awklau/SimpleClock/hardware/production/bom.csv

Name | Description | Designator | Footprint | LibRef | Quantity | Manufacturer | Manufacturer_Part_Number | Manufacturer_Name | Manufacturer Part Number
10uF | Chip Multilayer Ceramic Capacitors for General Purpose, 0805, 10uF, X5R, 15%, 10%, 50V | C1, C2, C3, C4, C7, C11, C13, C14, C15, C17, C19, C21, C23, C31 | FP-GRM21B-0_2-e0_2_0_7-IPC_A | CMP-06035-004402-1 | 14
1uF | CL21 Series 0805 1uF 50V ±10% Tolerance X7R Multilayer Ceramic Chip Capacitor | C5, C6, C8, C9, C10 | FP-CL21-IPC_C | CMP-13271-004196-1 | 5
100nF | Chip Capacitor,?100 nF, +/- 10%,?16 V, -55 to 125 degC, 0402 (1005 Metric), RoHS, Tape and Reel | C12, C16, C18, C20, C22, C24, C26, C27, C28, C29, C30, C32, C33, C34 | CAPC1050X55X23ML05T13 | CMP-2000-05439-1 | 14 | Samsung Electro-Mechanics
Capacitor 0.5 pF +/- 0.1pF 25 V 0402 |  | C25 | CAPC1005X56X25ML10T15 | CMP-001-00002-6 | 1
USBLC6-2P6 | TVS DIODE 5.25V 17V SOT666 | D1 | FP-SOT-666-MFG | CMP-12225-000058-1 | 1
LED_W | Chip LED, white | DS1, DS2, DS3 | EVRL-0603-2_V | CMP-007-00002-2 | 3 | Everlight Electronics
BLM18SP601SN1D | BLM18SP601SN1D Ferrite Bead, 600 Ohm, 1.5A, 0603 Rohs Compliant: Yes | FB1, FB2, FB3, FB4, FB5, FB6, FB7, FB8 | FP-BLM18-0_15-t0_8-MFG | CMP-00260-111572297-1 | 8
217179-0001 | CONN RCP USB2.0 TYP C 16P SMD RA | J1 | FP-2171790001-MFG | CMP-04767-000028-2 | 1
SMA-J-P-H-ST-MT1 | RF Connectors / Coaxial Connectors 6 GHz, 50 Ohm SMA Jack or Plug, Cable Connector | J2, J3, J4, J5, J6, J7, J8, J9, J10, J11, J12, J13, J14, J15, J16 | FP-SMA-J-P-H-ST-MT1-MFG | CMP-002-00073-1 | 15
2p header | simple 2p header | J17, J18 | New footprint 1 | CMP-002-00072-1 | 2
DLW21HN900SQ2L | CMC 330MA 2LN 90 OHM SMD | L1 | FP-DLW21HN-MFG | CMP-06045-000050-1 | 1
AO3400A | MOSFET N-CH 30V 5.7A SOT23 | Q1 | FP-SOT23-MFG | CMP-83955-000006-1 | 1
5.1k |  | R1, R2, R7, R8, R9, R13 | RESC1005X40X25LL10T10 | CMP-2002-05746-1 | 6 | TE Connectivity / AMP
22R2J | 22R 0.063W 5% 0402 (1005 Metric) SMD | R3, R6 | RESC0402(1005)_L | CMP-009-00082-2 | 2
Resistor 1k +/-1% 0402 100 mW | Chip Resistor, 1 KOhm, +/- 1%, 0.1 W, -55 to 155 degC, 0402 (1005 Metric) | R4, R5, R10, R11, R12 | RESC1005X40X25ML05T05 | CMP-009-00009-5 | 5
100k |  | R14 | RESC1005X40X25LL10T10 | CMP-2002-05746-1 | 1 | TE Connectivity / AMP
TLV76133KVU | 18 V, 1 A fixed 3.3 V LDO regulator; TI KVU (TO-252) | U1, U2 | TO-252-3_KVU_TI_TabPin2 | TLV76133KVU | 2 | Texas Instruments |  |  | TLV76133KVUR
STM32C071FBP6 | Mainstream Arm Cortex-M0+ MCU with 128 Kbytes of Flash memory, 24 Kbytes RAM, 48 MHz CPU, 2x USART, timers, ADC, comm. I/F, USB FS, 2-3.6V | U3 | TSSOP20_STM | STM32C071FBP6 | 1 |  | STM32C071FBP6 | STMicroelectronics
mosaic-G5-T | Septentrio mosaic-G5 T multi-frequency GNSS timing receiver module, manufacturer part 410504. The 40 internal ground lands are represented by logical pin G and must be tied to ground. Pin 5 (ANT_2) is unsupported on the single-antenna T model and must be left unconnected. | U4 | MOSAIC-G5_LGA54_22P8X16P4 | mosaic-G5-T | 1
LMK1C1108APWR | 1.8V,2.5V or 3.3V asynchronous 8 channel output LVCMOS buffer 16-TSSOP -40 to 125 | U5, U6 | TSSOP16_4P5X5P1_TEX | LMK1C1108APWR | 2 |  | LMK1C1108APWR | Texas Instruments
TMP117AIDRVR | TEMPERATURE SENSOR | U7 | FP-DRV0006B-IPC_C | CMP-04948-000036-1 | 1
SIT5801AB-KV033JV-10 | SiTime SiT5801 10 MHz digitally controlled precision OCXO, exact AB-KV033JV-10 ordering variant | Y1 | SiT5801_K_9x7_LGA11 | SIT5801AB-KV033JV-10 | 1 | SiTime |  |  | SIT5801AB-KV033JV-10
