awklau/SimpleClock/hardware/simple_clock.pdf

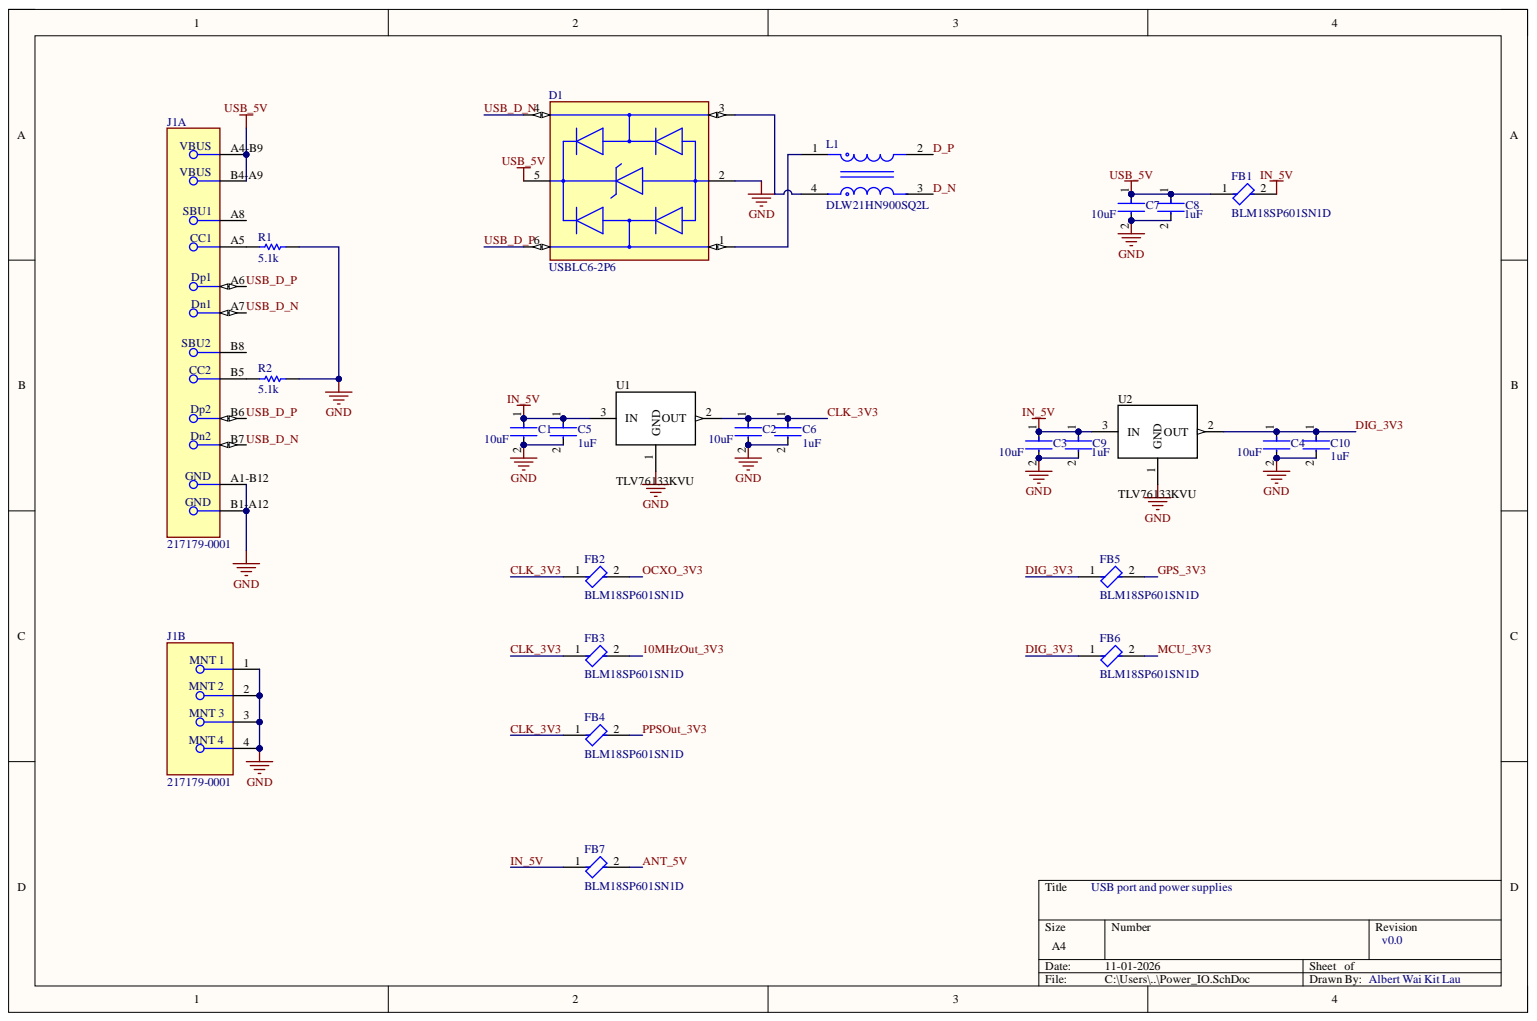
[picture p4: page 1]

USB port and power supplies

Albert Wai Kit Lau

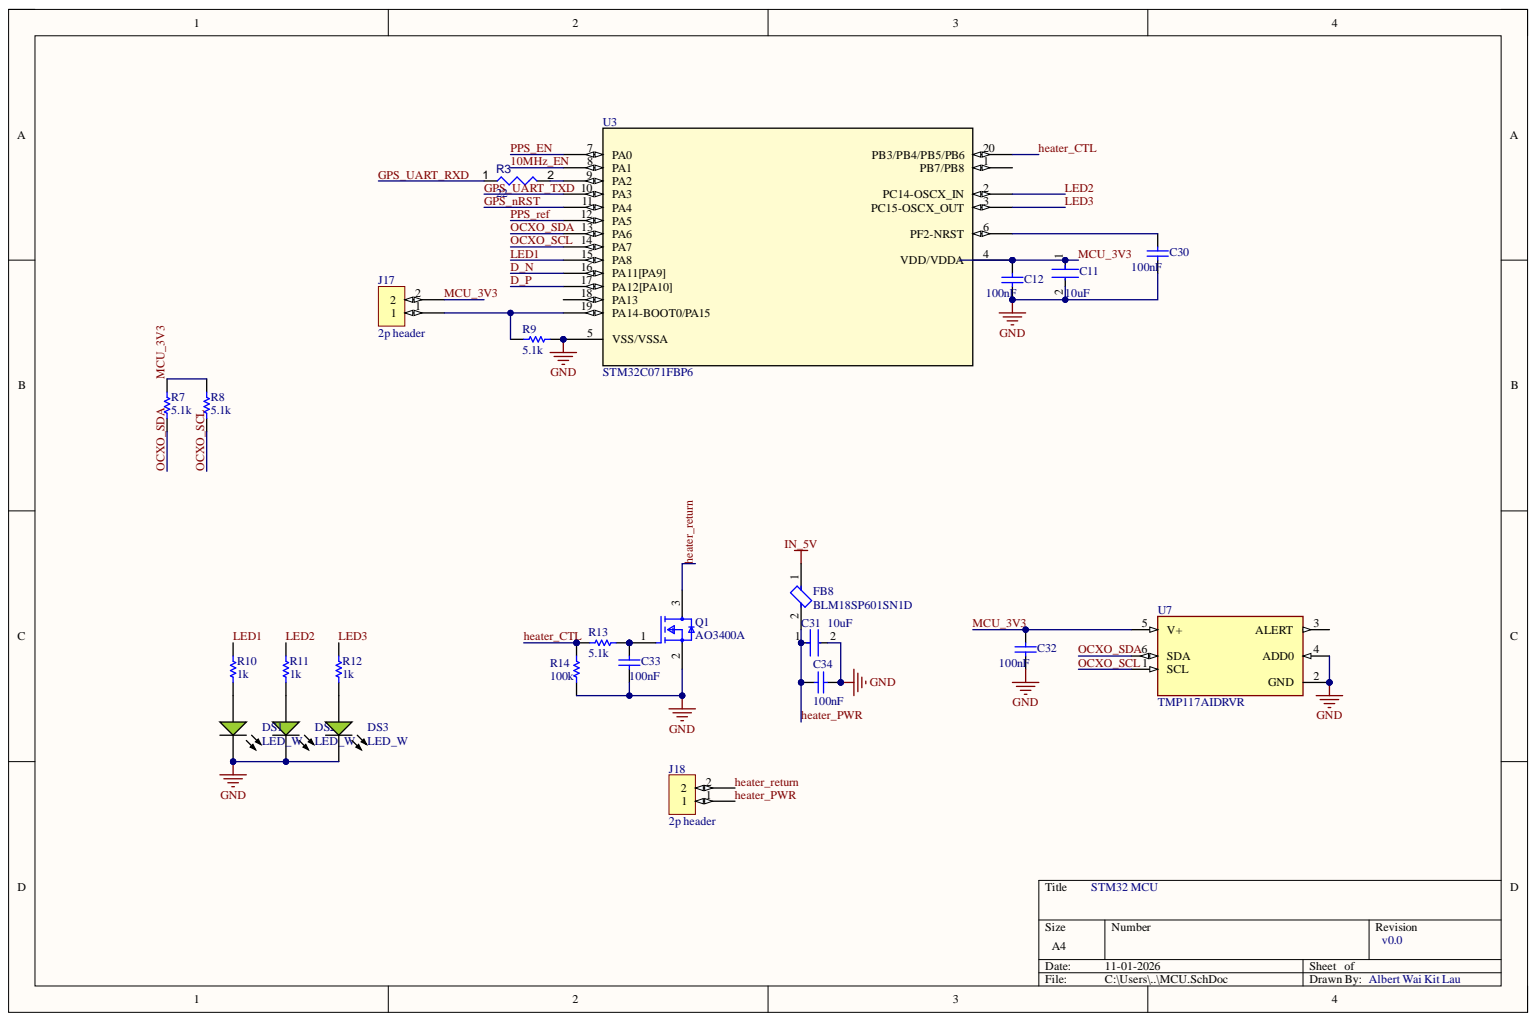
[picture p5: page 2]

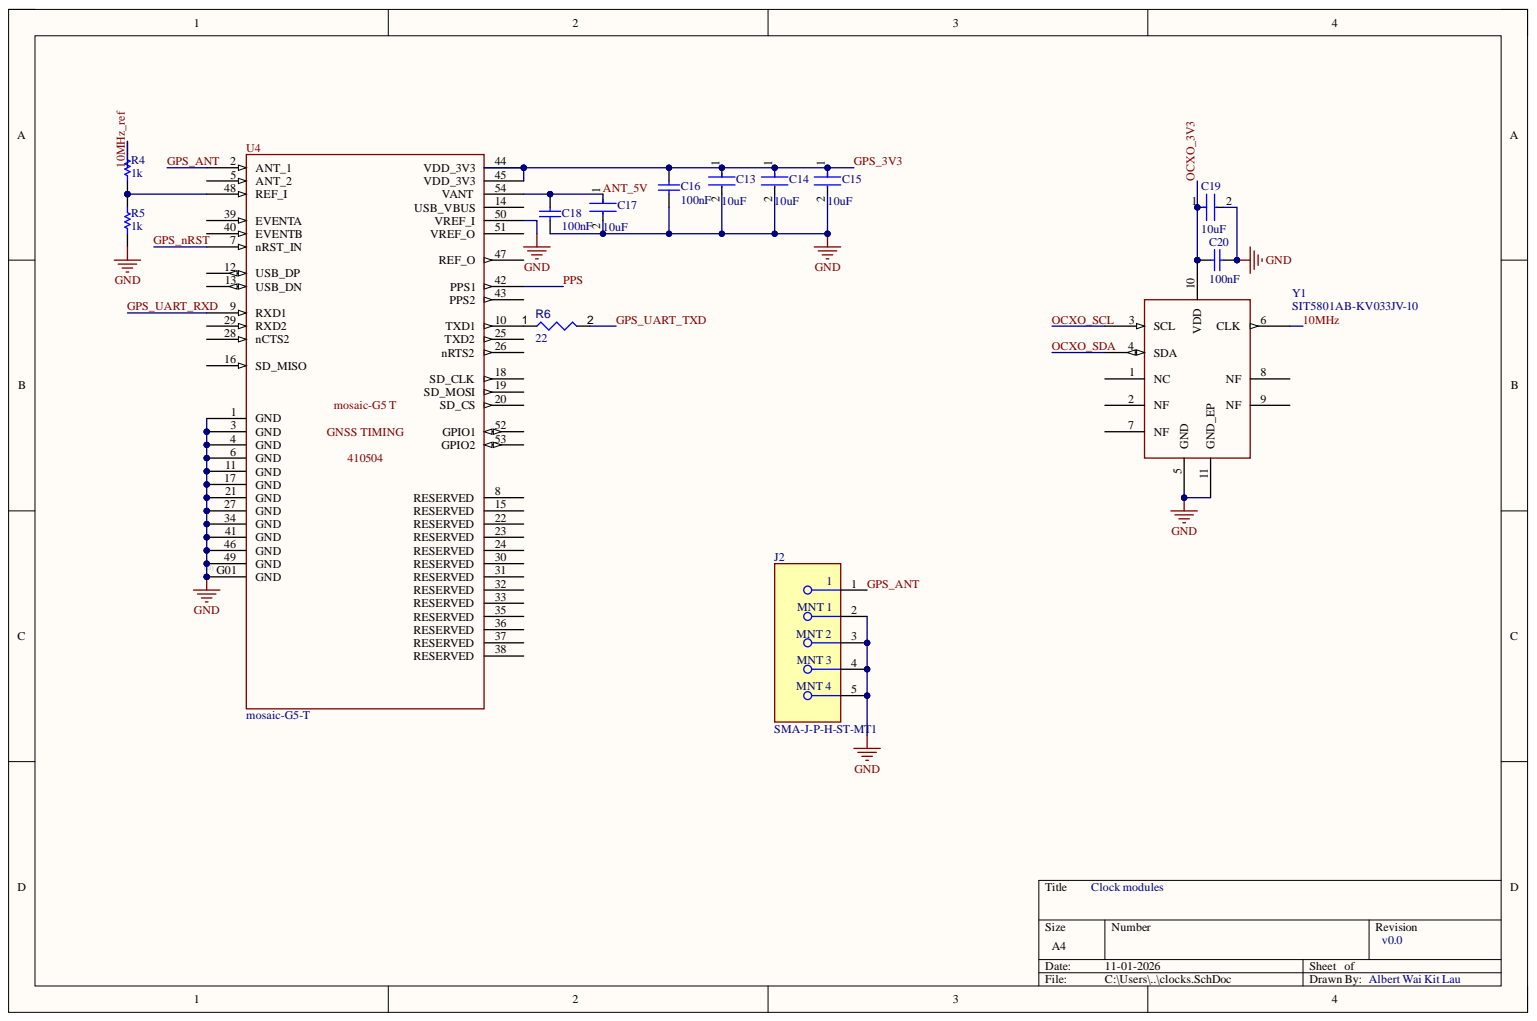
[picture p6: page 3]

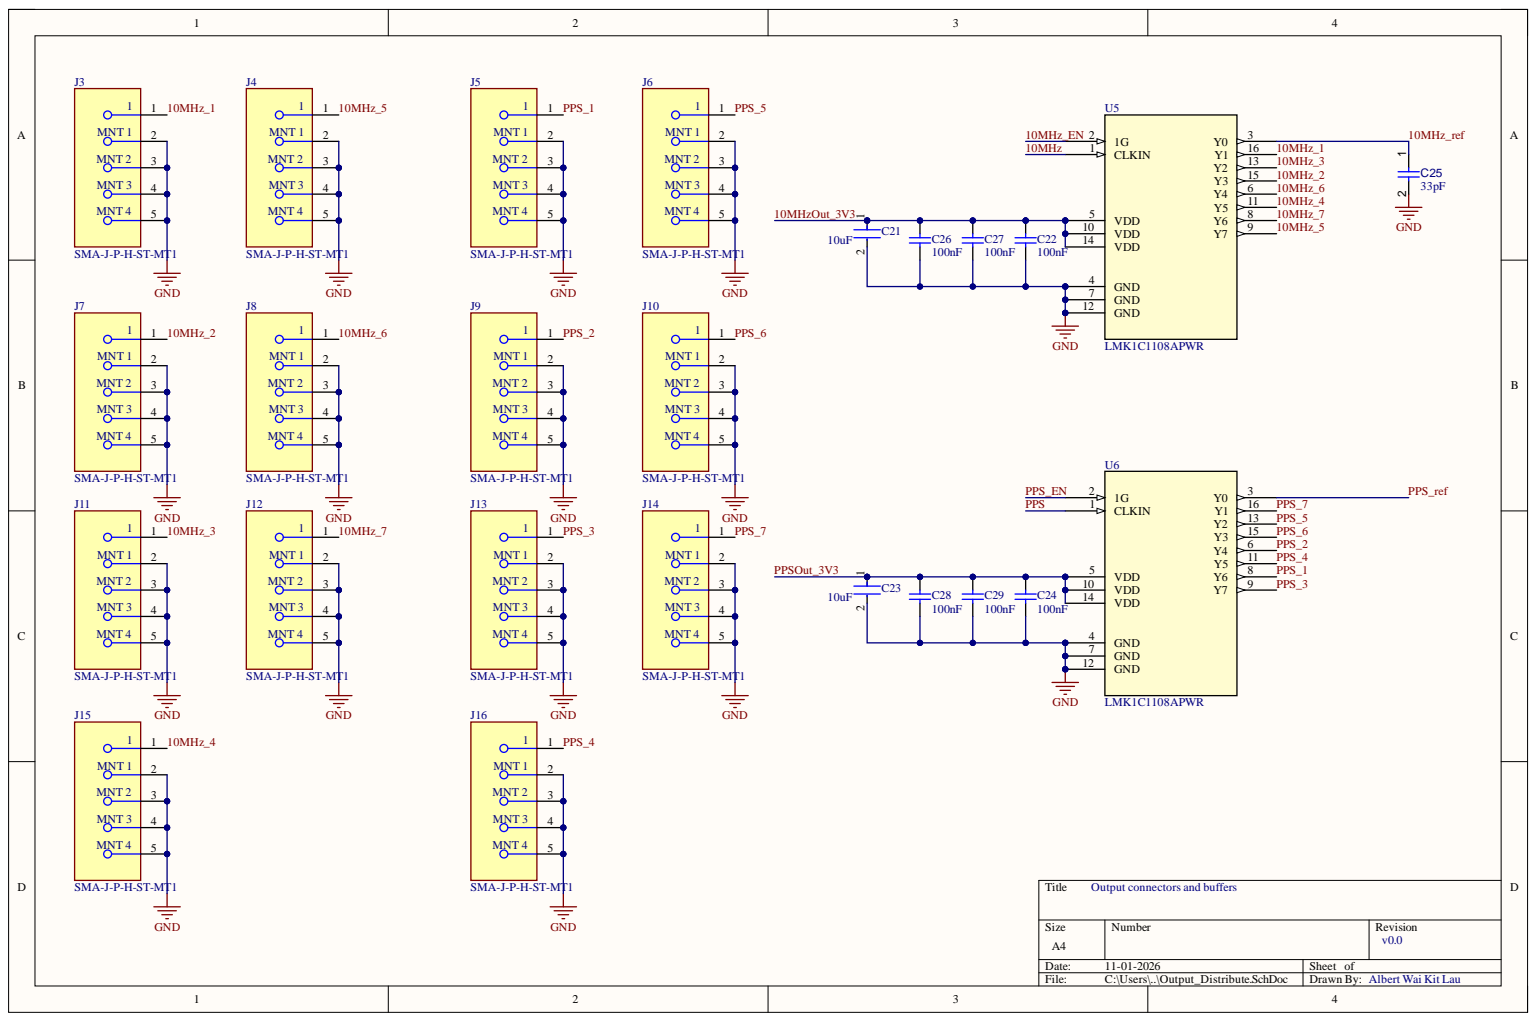
[picture p7: page 4]

Output connectors and buffers
