awklau/SimpleClock/(list of files, drawings)

Other design files:
hardware/altium/clocks.SchDoc
hardware/altium/main.PcbDoc
hardware/altium/main.PcbLib
hardware/altium/MCU.SchDoc
hardware/altium/Output_Distribute.SchDoc
hardware/altium/Power_IO.SchDoc
hardware/altium/PROJECT_LIB/simple_clock.SCHLIB
hardware/altium/simple_clock.PrjPcb
