awklau/SimpleClock/(commit log)

2026-10-31 Initial public source of SimpleClock
    GNSS-disciplined 10 MHz OCXO reference: STM32C071 firmware (temperature
    control and clock discipline from a Septentrio mosaic-G5 T), host tests,
    cross-platform flashing, receiver-upgrade and USB tools, and user and
    design documentation.
2026-10-31 test: parenthesize an intentional split string literal for Clang
    Clang's -Wstring-concatenation (an error under -Werror) flags adjacent
    literals in an array initializer; parentheses mark the split as intended.
    [test_gnss_auto.c]
2026-10-31 Firmware reports its release version (1.0.0-rc.1); deterministic host tests
    - core/include/simpleclock/version.h holds SC_FIRMWARE_VERSION; the
    resources and hybrid_config records report it as version=.
    - test_usb_capture ends when its fake port runs out of data instead of
    after 0.3 s of wall time, which a slow Windows CI runner missed.
    - test_gnss_control: 5 s limits for exchanges expected to complete.
    - Docs: version field in COMMANDS, USER_MANUAL and the firmware README.
    [clock_probe.c, hybrid_probe.c, test_gnss_control.py, test_hybrid_probe.c, test_usb_capture.py, version.h]
2026-11-01 Add hardware: board 00 prototype (Altium project, schematic, production files)
    - altium/: self-contained project (schematics, PCB, project libraries,
    ActiveBOM, output job).
    - production/gerber.zip: Gerbers (2026-11-01) and NC drill; geometry matches
    the built boards except for a silkscreen update.
    - production/bom.csv (UTF-8), production/pick-and-place.csv.
    - simple_clock.pdf schematic and a hardware README (JLC04161H-7628 stackup,
    50-ohm clock and antenna traces, assembly notes).
    - .gitattributes stores hardware/ byte-exact; Altium files are binary.
    [MCU.SchDoc, Output_Distribute.SchDoc, Power_IO.SchDoc, bom.csv, clocks.SchDoc, main.PcbDoc, main.PcbLib, pick-and-place.csv]
2026-11-01 Set the first public release version to 0.0.0 (board 00 prototype)
    The firmware reports version=0.0.0 in resources and hybrid_config.
    AUTO image 188265d51bfe (112,404 B); GNSS bridge unchanged.
2026-11-09 Drift-only fallback, robust receiver changes and pre-release fixes
    - Below the selected GNSS solution (a fallback) only the frequency loop
    steers (Tf 10 s); after a return to PPP it runs alone for at least 1000 s
    before phase restarts from a fresh, logged anchor. clock_guard v3 reports
    fallback and settling. A 0/0 pair never steers on its solution type.
    - Receiver changes (selection, masks, gnss write) hold the clock first and
    wait for the oscillator write to settle; a failed selection change ends in
    the mode the receiver actually runs instead of a latched fault.
    - Boot trim envelope +/-1000 ppb (sanity bound covering initial offset and
    ageing); phase-only tracking bounded to +/-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
    [gnss_probe.c, hybrid.c, hybrid.h, hybrid_probe.c, test_gnss_auto.c, test_hybrid_coupled.c, test_hybrid_faults.c]
2026-11-10 Landing page from the paper; user manual becomes docs/README.md
    The README gains photos, an at-a-glance table, the architecture diagram
    and the five 200 000 s stability results. The user manual is renamed so
    GitHub shows it for docs/. CITATION.cff takes the paper title.
